maksimum380/Spot-Welder/Hard/PDF/Spot welder - control - PRINT.pdf

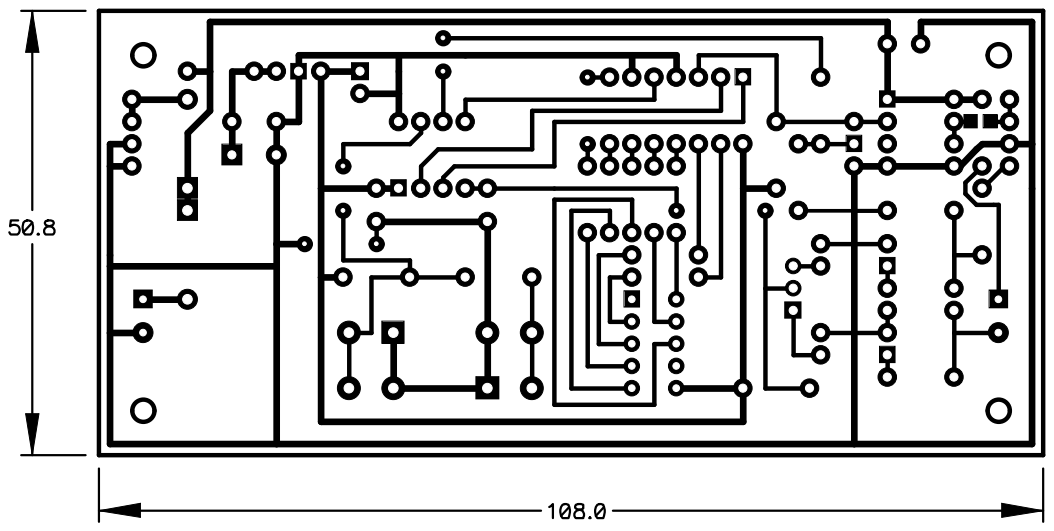
[picture p10: page 1]
