maksimum380/Spot-Welder/Hard/PDF/Spot welder - power PRINT.pdf

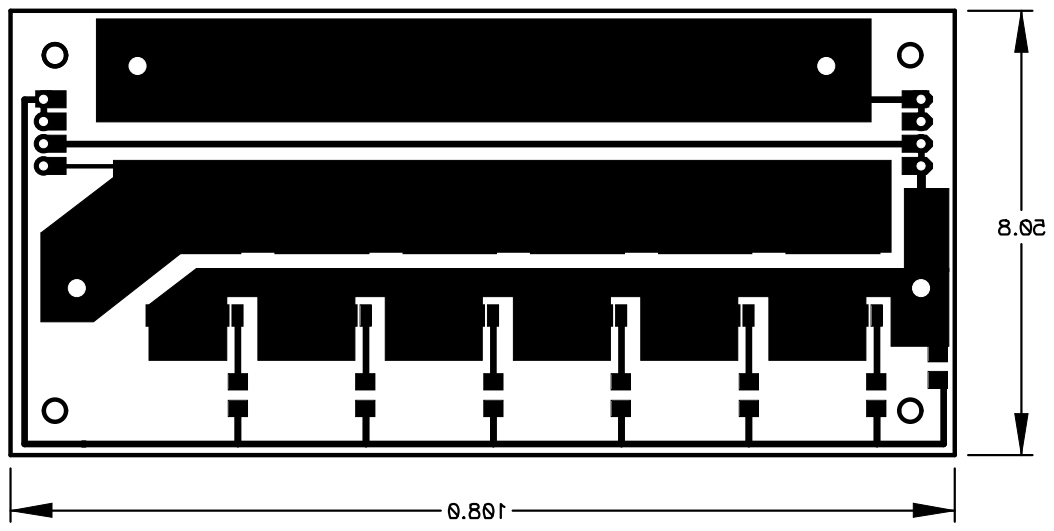
[picture p11: page 1]
