maksimum380/Spot-Welder/Hard/PDF/Spot welder - power REF.pdf

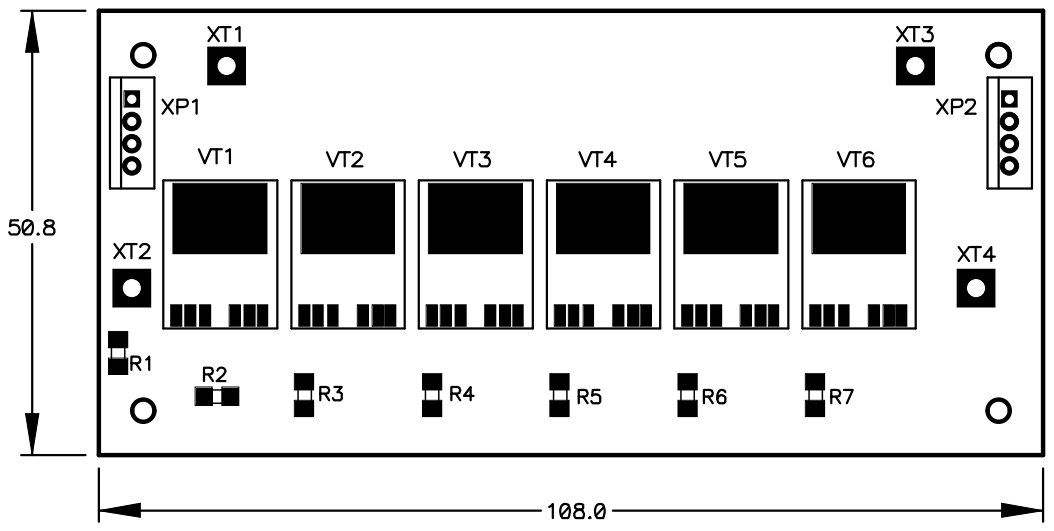
[picture p12: page 1]
