maksimum380/Spot-Welder/Hard/PDF/Spot welder - control - TOP.pdf

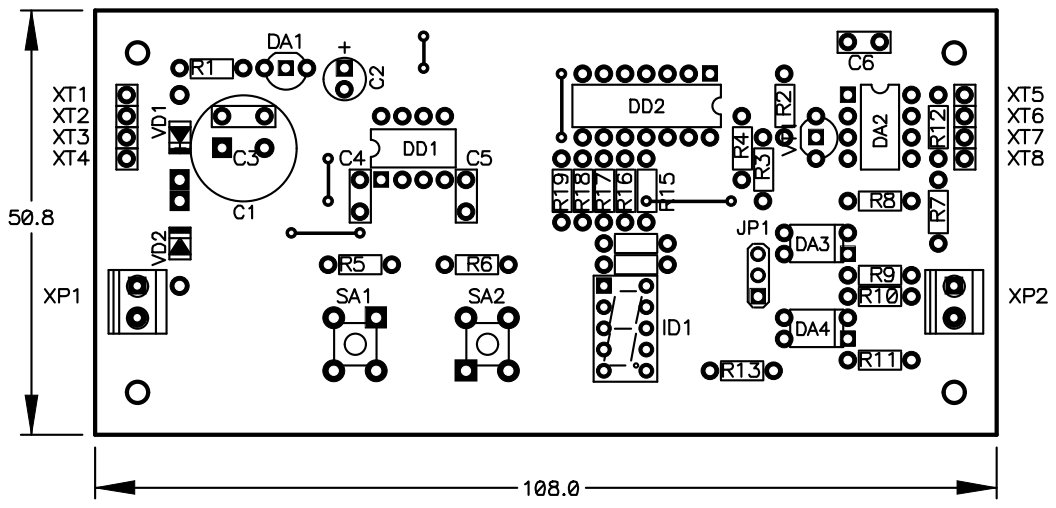
[picture p13: page 1]
