maksimum380/Spot-Welder/Hard/PDF/Spot welder - control.pdf

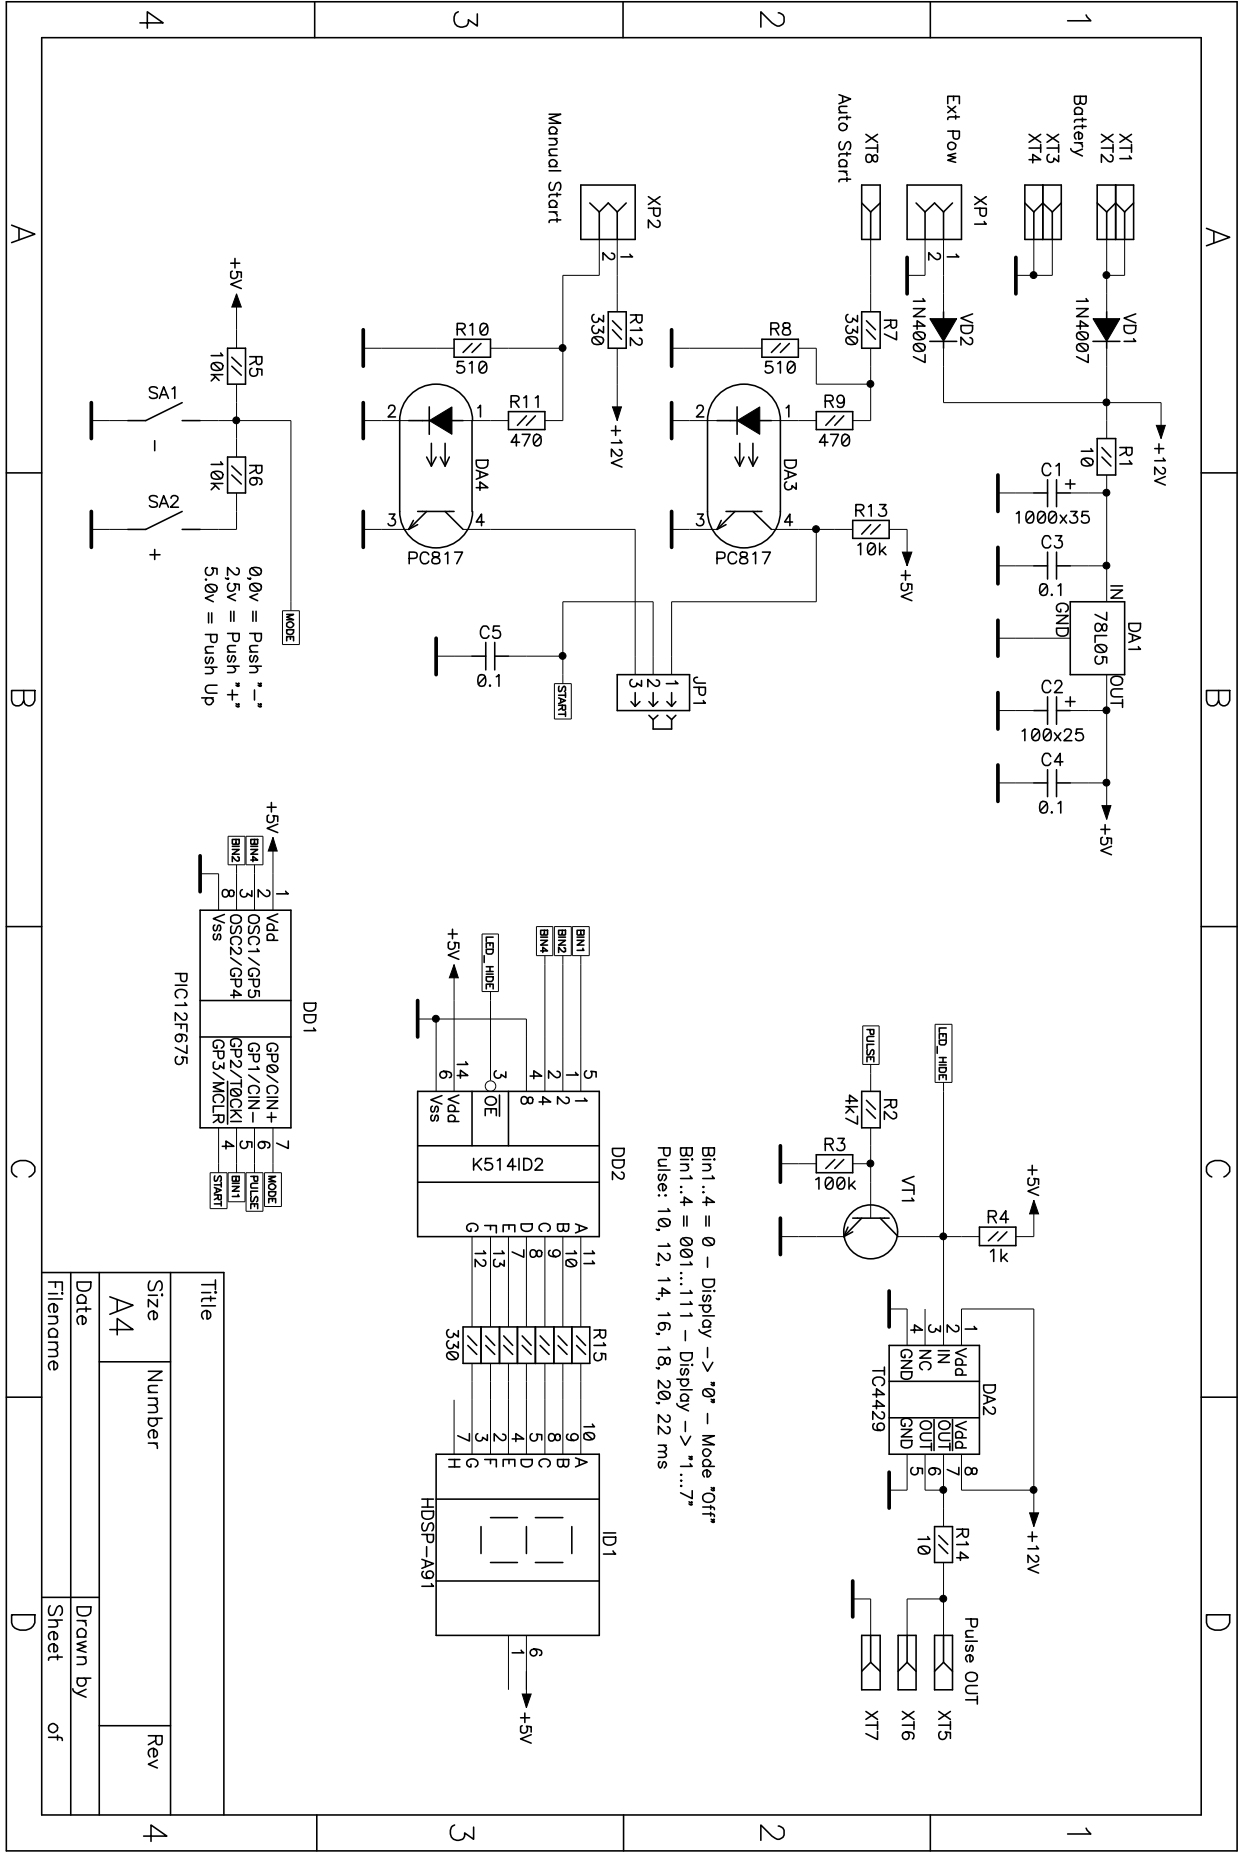
[picture p14: page 1]
