maksimum380/Spot-Welder/Hard/PDF/Spot welder - power TOP.pdf

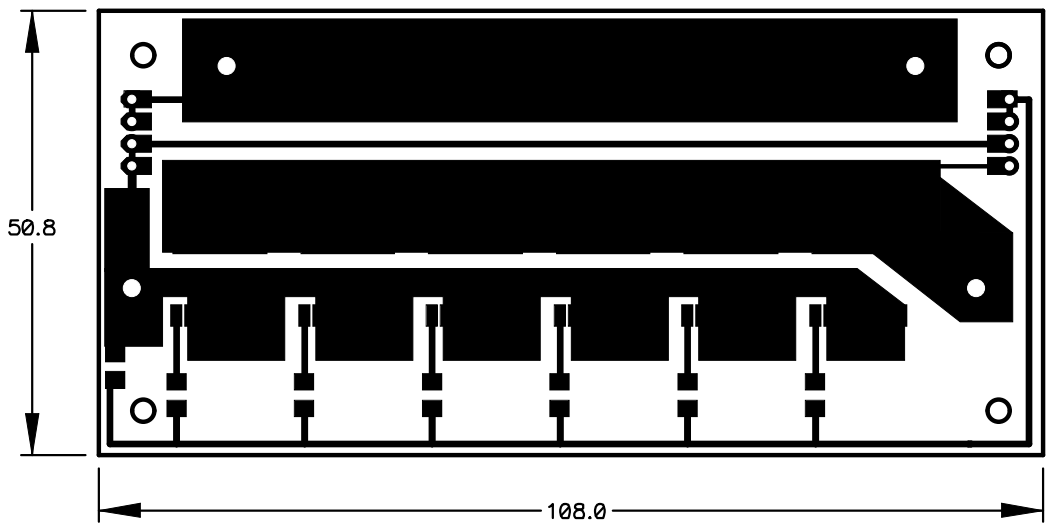
[picture p15: page 1]
