maksimum380/Spot-Welder/Hard/PDF/Spot welder - power.pdf

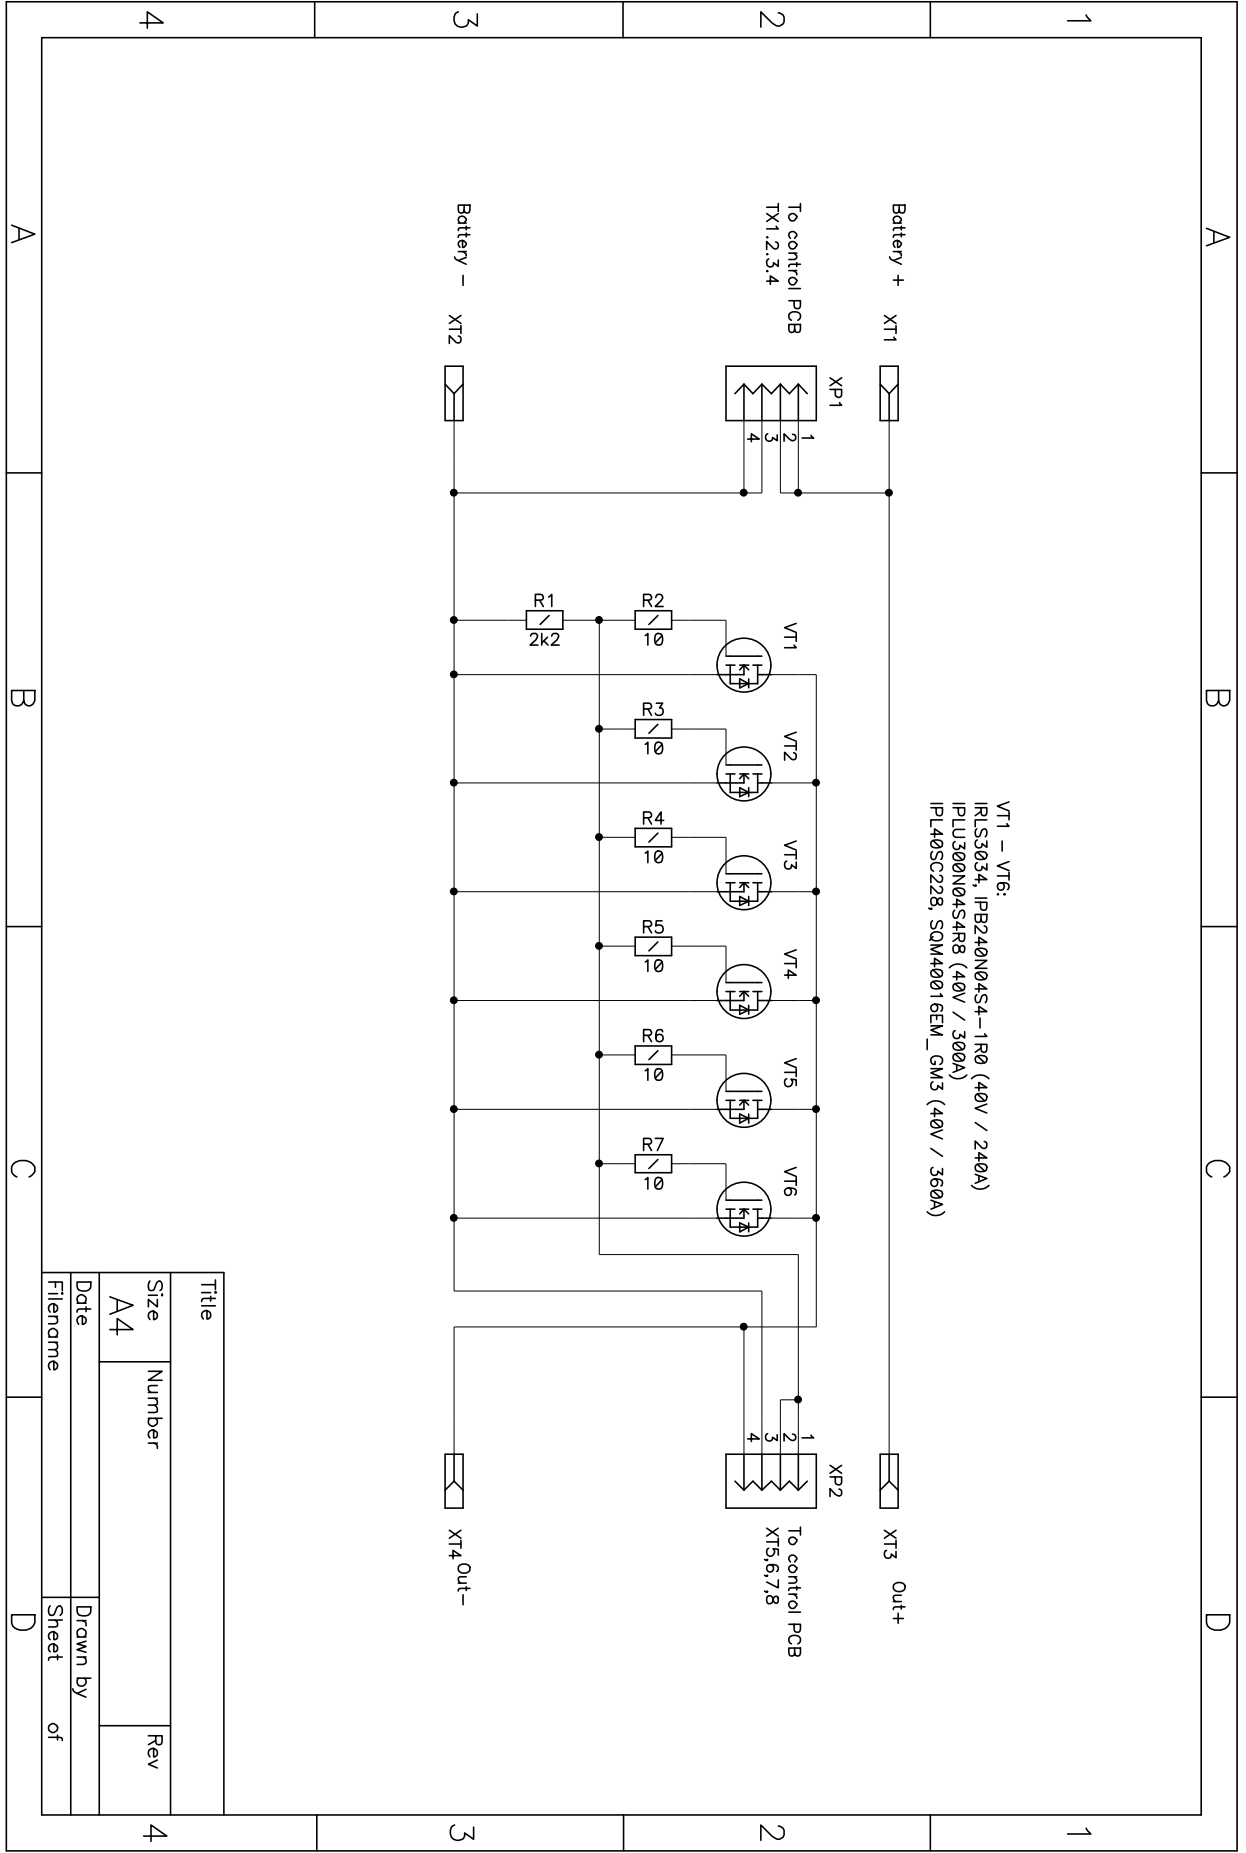
[picture p16: page 1]
