maksimum380/Spot-Welder/(list of files, drawings)

Other design files:
Hard/PCAD/Spot welder - control.pcb
Hard/PCAD/Spot welder - power.pcb
