maksimum380/Spot-Welder/(commit log)

2023-02-10 add files to hard
    [Spot welder - control.pcb, Spot welder - control.sch, Spot welder - power.pcb, Spot welder - power.sch]
2023-02-10 add files to soft
    [DurationPulse.xlsm]
2023-02-10 Update README.md
    Рідна мова.
